gijsdevries/esmog_snuffelaar/README.md

# esmog_snuffelaar

## Software

## Hardware
### Orders
   - **Order #1** v1.0, 22-6-26, ce8a10
