gijsdevries/esmog_snuffelaar/KiCad/TAPIR E-Smog-Snuffelaar.odt

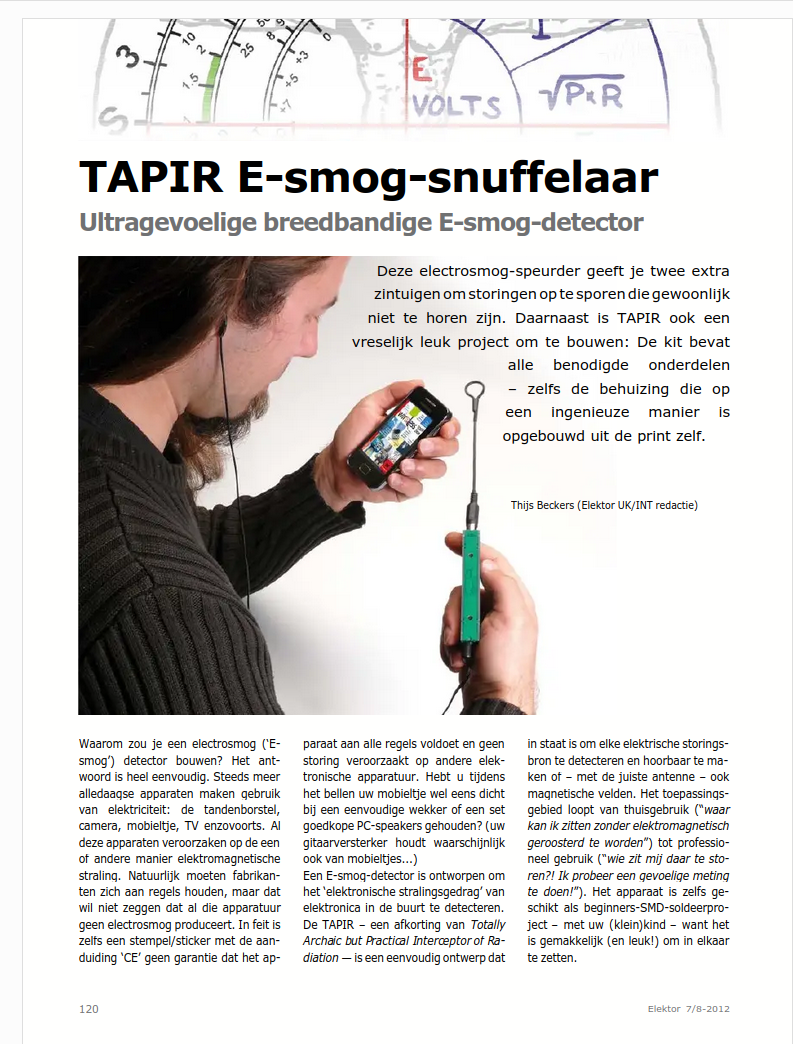
[picture p1: figure]
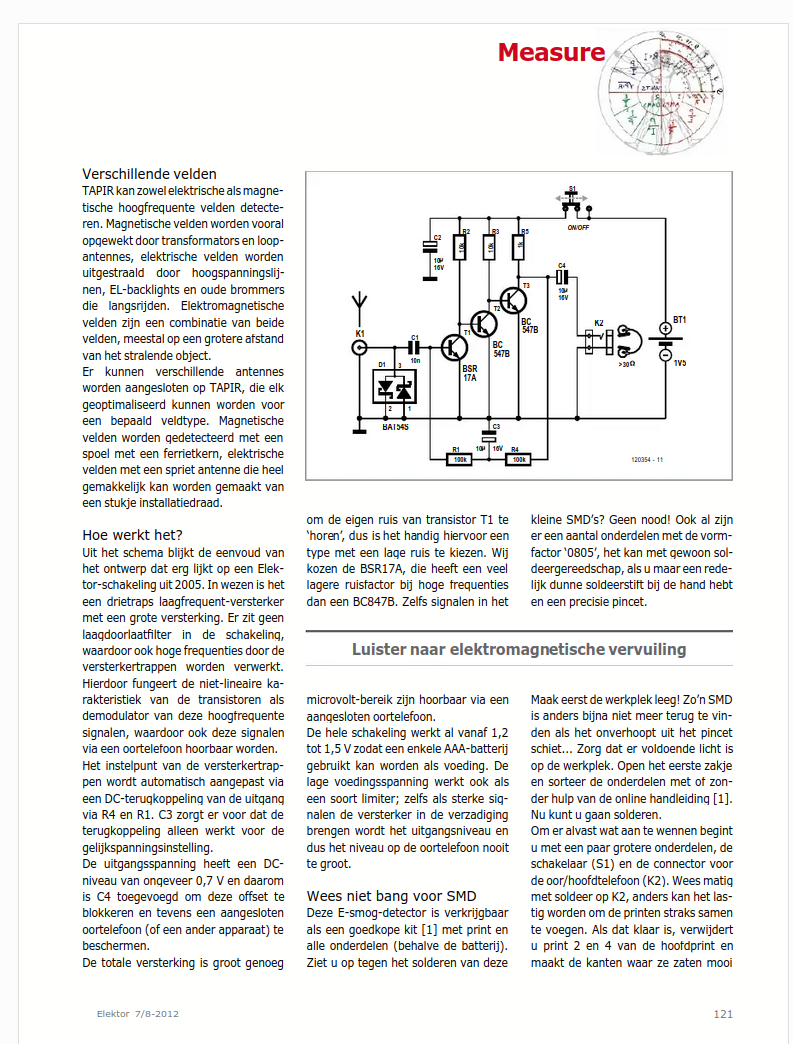
[picture p2: figure]
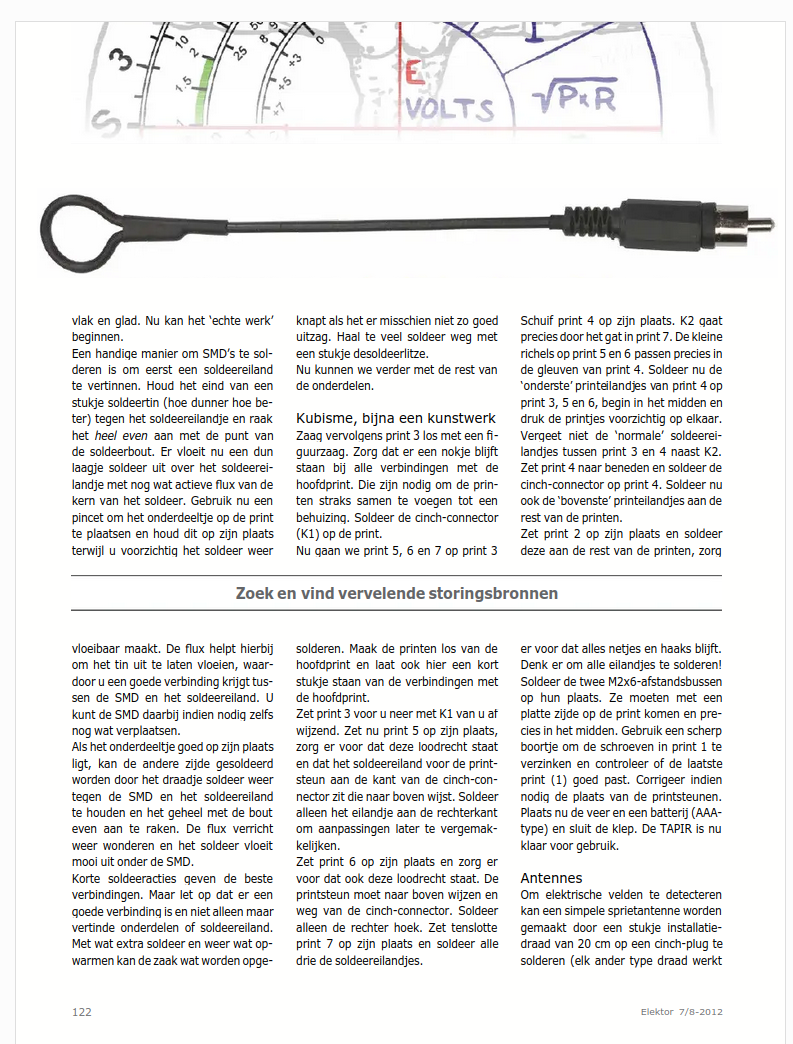
[picture p3: figure]
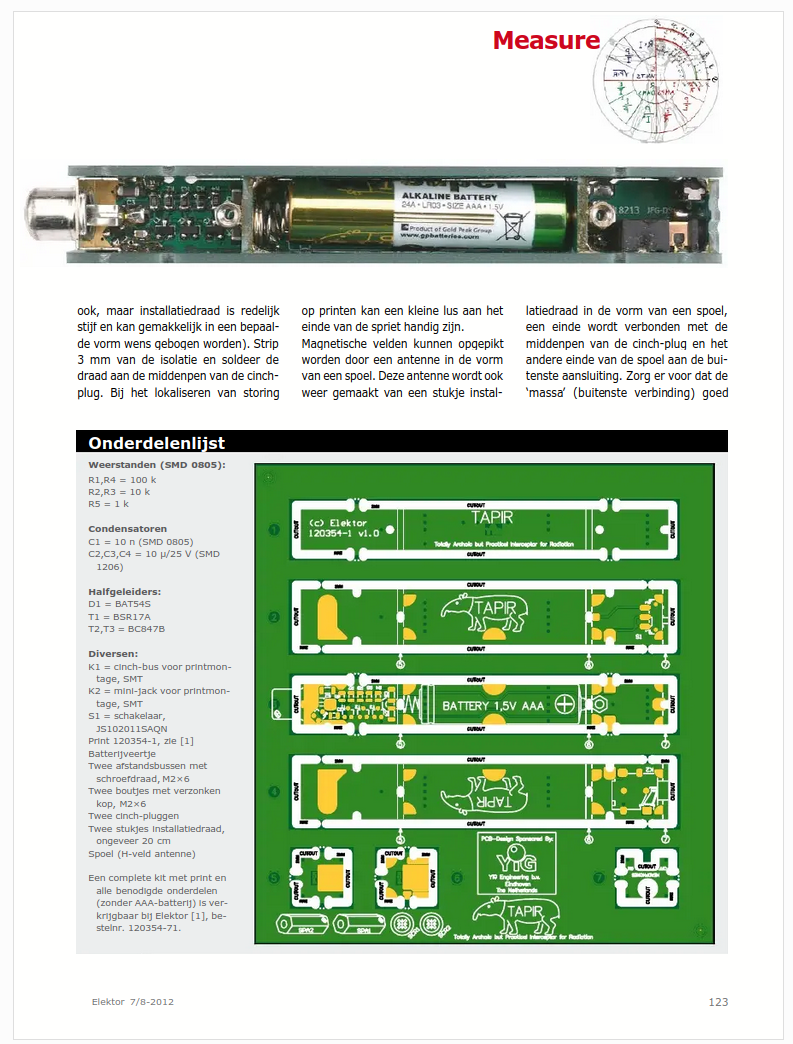
[picture p4: figure]
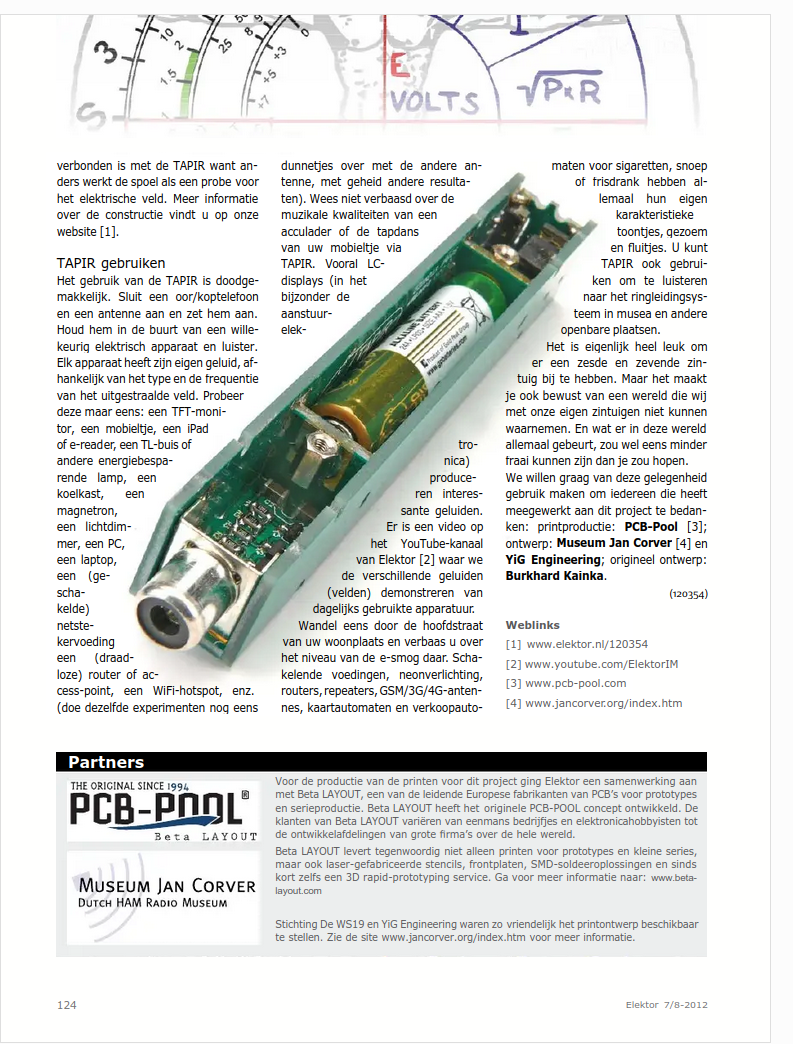
[picture p5: figure]
