gijsdevries/esmog_snuffelaar/KiCad/step/SJ2-35894D-SMT-TR--3DModel-STEP-1.STEP

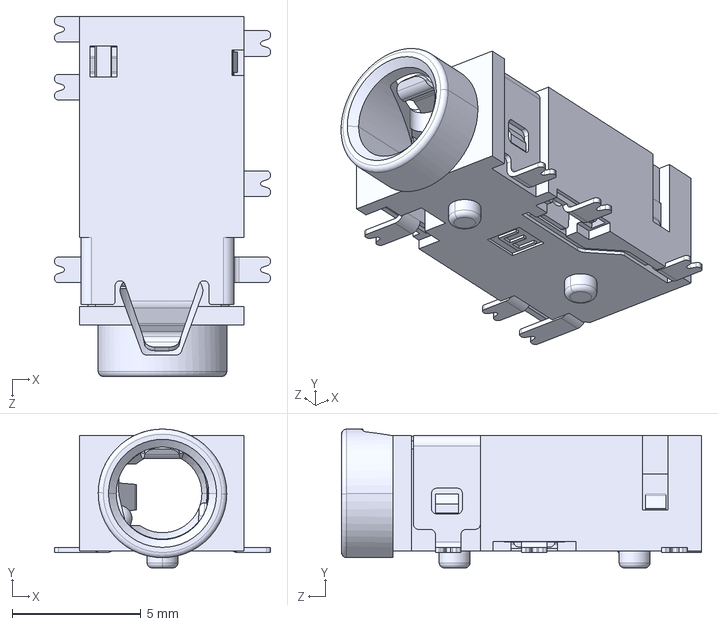
[picture p6: CAD file, 2026-06-19]
KiCad/step/SJ2-35894D-SMT-TR--3DModel-STEP-1.STEP
8.40 x 5.40 x 14.0 mm
