gijsdevries/esmog_snuffelaar/KiCad/step/RCJ-042--3DModel-STEP-1.STEP

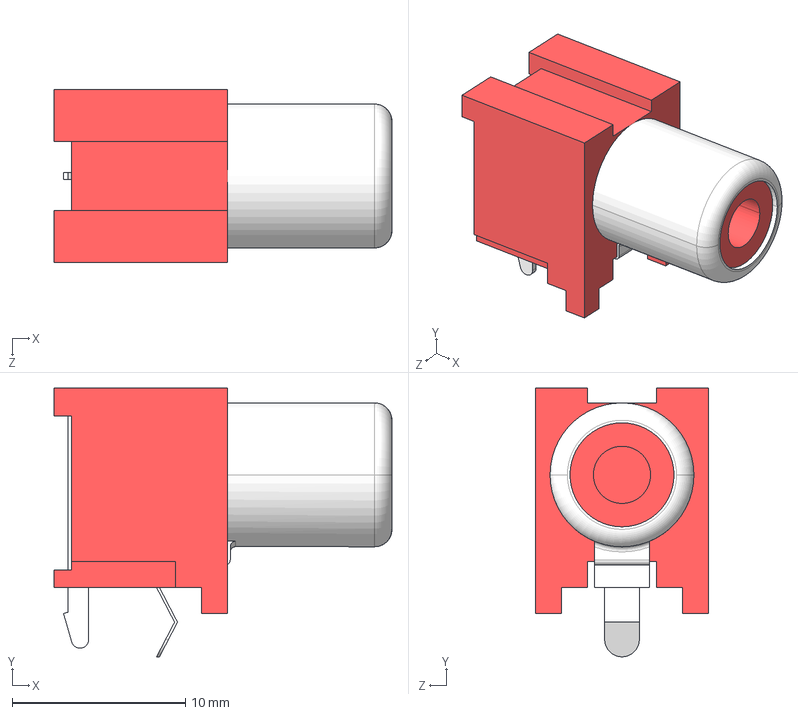
[picture p7: CAD file, 2026-06-19]
KiCad/step/RCJ-042--3DModel-STEP-1.STEP
19.5 x 15.5 x 10.0 mm
