gijsdevries/esmog_snuffelaar/KiCad/Esmog_snuffelaar.kicad_pcb

## KiCad design KiCad/Esmog_snuffelaar.kicad_pcb (2026-06-22)

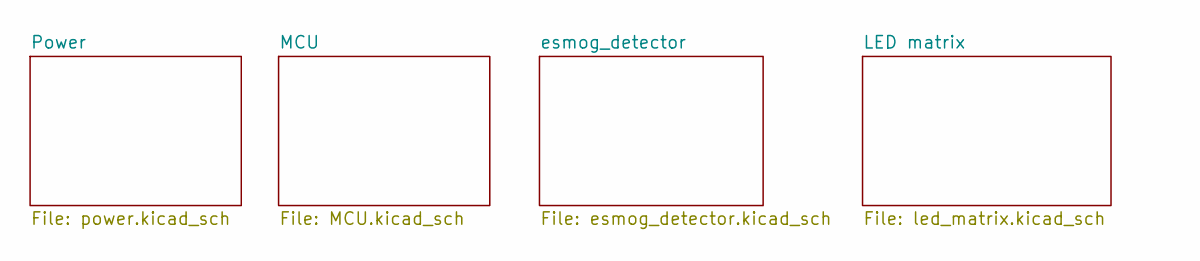
[picture p8: schematic Esmog_snuffelaar.kicad_sch, E smog snuffelaar - Gijs de Vries]

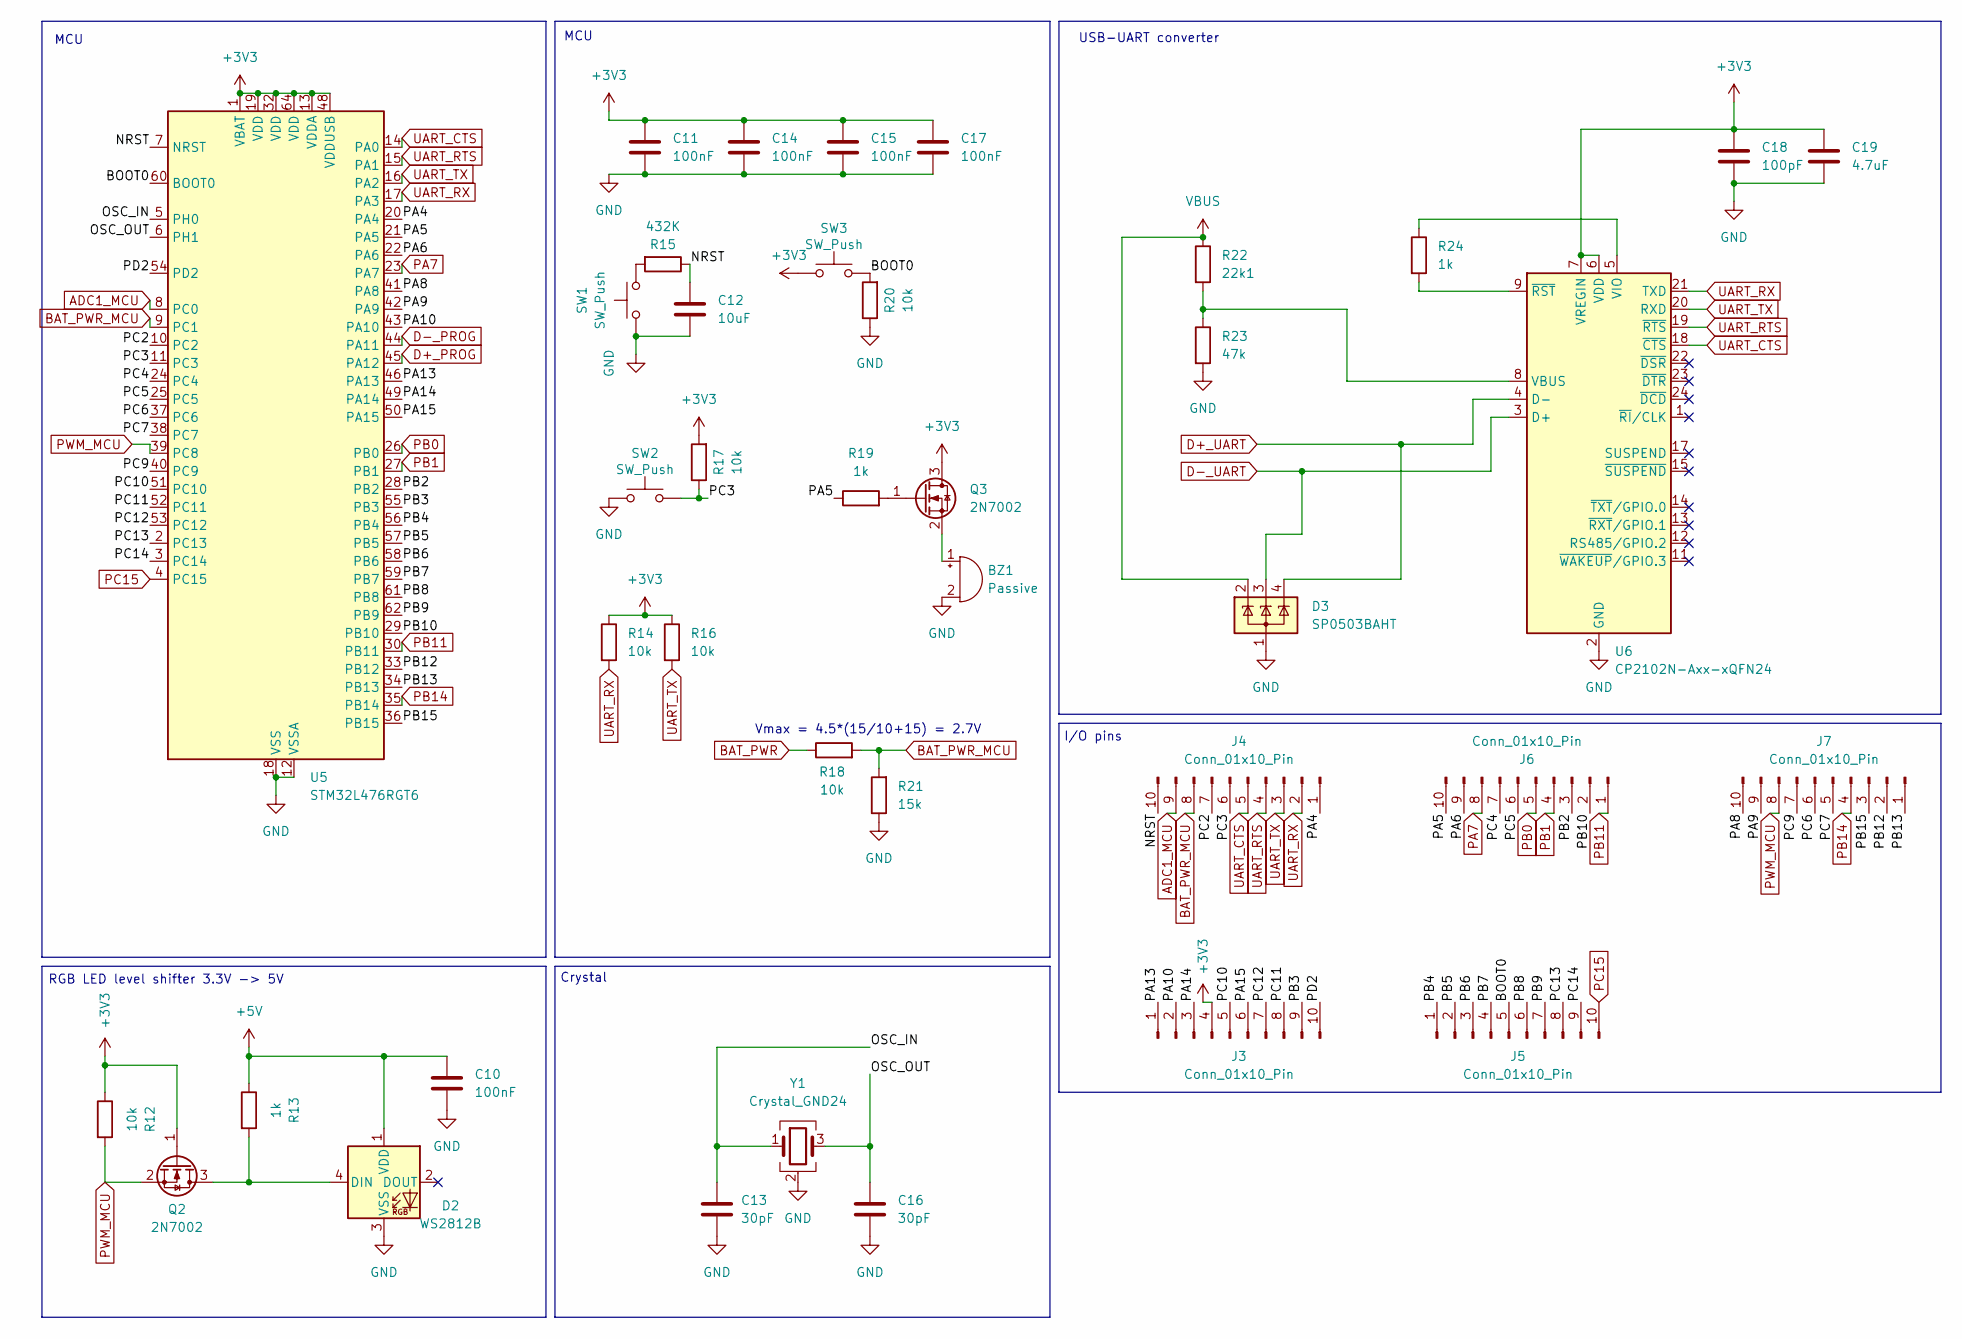
[picture p9: schematic MCU.kicad_sch]

Parts:
BZ1: Passive; Buzzer_TDK_PS1240P02BT_D12.2mm_H6.5mm; JLCPCB Part C76871
C10, C11, C14, C15, C17: 100nF; C_0603_1608Metric_Pad1.08x0.95mm_HandSolder; JLCPCB Part C1591
C12: 10uF; C_0603_1608Metric_Pad1.08x0.95mm_HandSolder; JLCPCB Part C1691
C13, C16: 30pF; C_0603_1608Metric_Pad1.08x0.95mm_HandSolder; JLCPCB Part C1658
C18: 100pF; C_0603_1608Metric_Pad1.08x0.95mm_HandSolder; JLCPCB Part C14858
C19: 4.7uF; C_0603_1608Metric_Pad1.08x0.95mm_HandSolder; JLCPCB Part C1705
D2: WS2812B; LED_WS2812B_PLCC4_5.0x5.0mm_P3.2mm; JLCPCB Part C527089
D3: SP0503BAHT; SOT-143; JLCPCB Part C7074
J3, J4, J5, J6, J7: Conn_01x10_Pin; PinHeader_2x05_P2.54mm_Vertical; JLCPCB Part C42431818
Q2, Q3: 2N7002; SOT-23; JLCPCB Part C916396
R12, R14, R16, R17, R18, R20: 10k; R_0603_1608Metric_Pad0.98x0.95mm_HandSolder; JLCPCB Part C2930027
R13, R19, R24: 1k; R_0603_1608Metric_Pad0.98x0.95mm_HandSolder; JLCPCB Part C2907002
R15: 432K; R_0603_1608Metric_Pad0.98x0.95mm_HandSolder; JLCPCB Part C234529
R21: 15k; R_0603_1608Metric_Pad0.98x0.95mm_HandSolder; JLCPCB Part C114682
R22: 22k1; R_0603_1608Metric_Pad0.98x0.95mm_HandSolder; JLCPCB Part C25961
R23: 47k; R_0603_1608Metric_Pad0.98x0.95mm_HandSolder; JLCPCB Part C2907042
SW1, SW2, SW3: SW_Push; SW_Push_SPST_NO_Alps_SKRK; JLCPCB Part C115357
U5: STM32L476RGT6; LQFP-64_10x10mm_P0.5mm; JLCPCB Part C74797
U6: CP2102N-Axx-xQFN24; QFN-24-1EP_4x4mm_P0.5mm_EP2.6x2.6mm; JLCPCB Part C964632
Y1: Crystal_GND24; Crystal_SMD_Abracon_ABM8AIG-4Pin_3.2x2.5mm; JLCPCB Part C9002

Connections:
+3V3: C11.2, C14.2, C15.2, C17.2, C18.1, C19.1, J3.4, Q2.1 (G), Q3.3 (D), R12.1, R14.1, R16.1, R17.2, SW3.1, U5.1 (VBAT), U5.13 (VDDA), U5.19 (VDD), U5.32 (VDD), U5.48 (VDDUSB), U5.64 (VDD), U6.6 (VDD), U6.7 (VREGIN); also elsewhere on the board
+5V: C10.2, D2.1 (VDD), R13.1; also elsewhere on the board
/MCU/BOOT0: J5.5, R20.2, SW3.2, U5.60 (BOOT0)
/MCU/NRST: C12.2, J4.10, R15.1, U5.7 (NRST)
/MCU/OSC_IN: C13.2, U5.5 (PH0), Y1.1
/MCU/OSC_OUT: C16.2, U5.6 (PH1), Y1.3
/MCU/PA4: J4.1, U5.20 (PA4)
/MCU/PA5: J6.10, R19.1, U5.21 (PA5)
/MCU/PA6: J6.9, U5.22 (PA6)
/MCU/PA8: J7.10, U5.41 (PA8)
/MCU/PA9: J7.9, U5.42 (PA9)
/MCU/PA10: J3.2, U5.43 (PA10)
/MCU/PA13: J3.1, U5.46 (PA13)
/MCU/PA14: J3.3, U5.49 (PA14)
/MCU/PA15: J3.6, U5.50 (PA15)
/MCU/PB2: J6.3, U5.28 (PB2)
/MCU/PB3: J3.9, U5.55 (PB3)
/MCU/PB4: J5.1, U5.56 (PB4)
/MCU/PB5: J5.2, U5.57 (PB5)
/MCU/PB6: J5.3, U5.58 (PB6)
/MCU/PB7: J5.4, U5.59 (PB7)
/MCU/PB8: J5.6, U5.61 (PB8)
/MCU/PB9: J5.7, U5.62 (PB9)
/MCU/PB10: J6.2, U5.29 (PB10)
/MCU/PB12: J7.2, U5.33 (PB12)
/MCU/PB13: J7.1, U5.34 (PB13)
/MCU/PB15: J7.3, U5.36 (PB15)
/MCU/PC2: J4.7, U5.10 (PC2)
/MCU/PC3: J4.6, R17.1, SW2.2, U5.11 (PC3)
/MCU/PC4: J6.7, U5.24 (PC4)
/MCU/PC5: J6.6, U5.25 (PC5)
/MCU/PC6: J7.6, U5.37 (PC6)
/MCU/PC7: J7.5, U5.38 (PC7)
/MCU/PC9: J7.7, U5.40 (PC9)
/MCU/PC10: J3.5, U5.51 (PC10)
/MCU/PC11: J3.8, U5.52 (PC11)
/MCU/PC12: J3.7, U5.53 (PC12)
/MCU/PC13: J5.8, U5.2 (PC13)
/MCU/PC14: J5.9, U5.3 (PC14)
/MCU/PD2: J3.10, U5.54 (PD2)
ADC1_MCU: J4.9, U5.8 (PC0); also elsewhere on the board
BAT_PWR: R18.1; also elsewhere on the board
BAT_PWR_MCU: J4.8, R18.2, R21.2, U5.9 (PC1)
D+_PROG: U5.45 (PA12); also elsewhere on the board
D+_UART: D3.4 (K), U6.4 (D-); also elsewhere on the board
D-_PROG: U5.44 (PA11); also elsewhere on the board
D-_UART: D3.3 (K), U6.3 (D+); also elsewhere on the board
GND: BZ1.2 (-), C10.1, C11.1, C12.1, C13.1, C14.1, C15.1, C16.1, C17.1, C18.2, C19.2, D2.3 (VSS), D3.1 (A), R20.1, R21.1, R23.2, SW1.1, SW2.1, U5.12 (VSSA), U5.18 (VSS), U5.31 (VSS), U5.47 (VSS), U5.63 (VSS), U6.2 (GND), U6.25 (GND), Y1.2 (G), Y1.4 (G); also elsewhere on the board
unnamed: BZ1.1 (+), Q3.2 (S)
unnamed: D2.4 (DIN), Q2.3 (D), R13.2
unnamed: Q3.1 (G), R19.2
unnamed: R15.2, SW1.2
unnamed: R22.2, R23.1, U6.8 (VBUS)
unnamed: R24.1, U6.5 (VIO)
unnamed: R24.2, U6.9 (~RST)
PA7: J6.8, U5.23 (PA7); also elsewhere on the board
PB0: J6.5, U5.26 (PB0); also elsewhere on the board
PB1: J6.4, U5.27 (PB1); also elsewhere on the board
PB11: J6.1, U5.30 (PB11); also elsewhere on the board
PB14: J7.4, U5.35 (PB14); also elsewhere on the board
PC15: J5.10, U5.4 (PC15)
PWM_MCU: J7.8, Q2.2 (S), R12.2, U5.39 (PC8)
UART_CTS: J4.5, U5.14 (PA0), U6.18 (~CTS)
UART_RTS: J4.4, U5.15 (PA1), U6.19 (~RTS)
UART_RX: J4.2, R14.2, U5.17 (PA3), U6.21 (TXD)
UART_TX: J4.3, R16.2, U5.16 (PA2), U6.20 (RXD)
VBUS: D3.2 (K), R22.1; also elsewhere on the board

Notes on the sheet:
MCU
I/O pins
Crystal
Vmax = 4.5*(15/10+15) = 2.7V
RGB LED level shifter 3.3V -> 5V
USB-UART converter

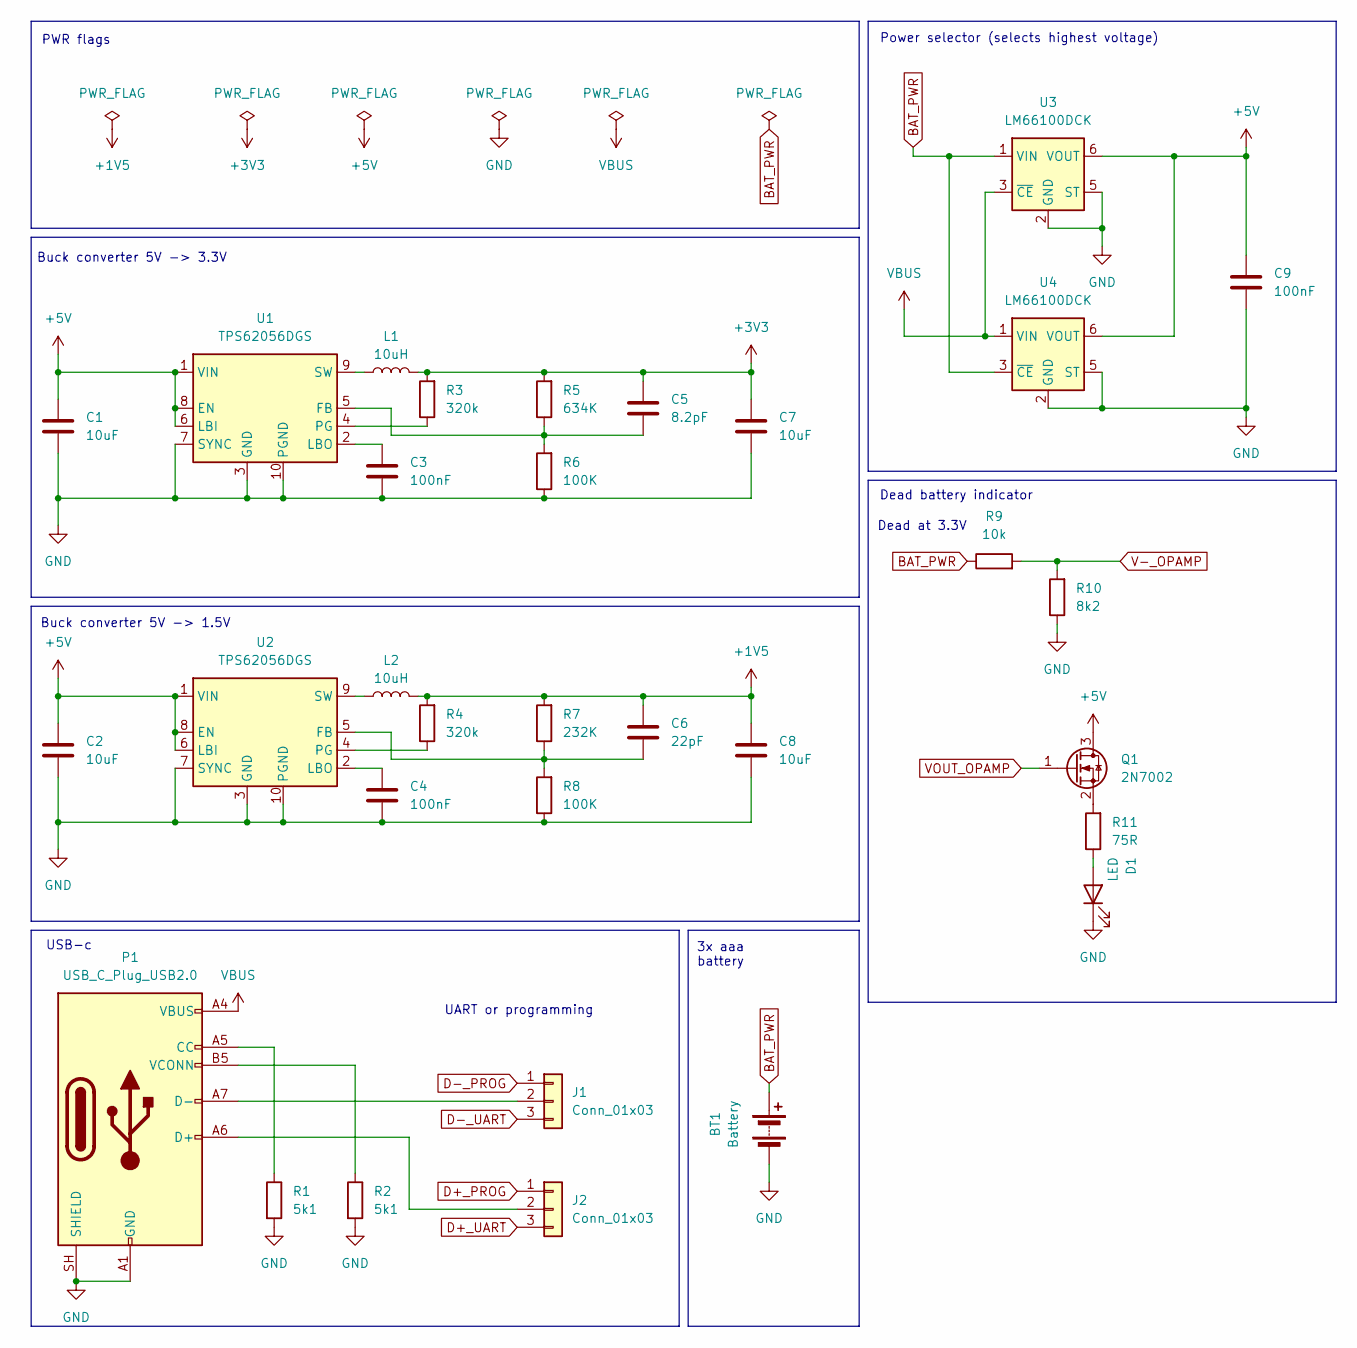
[picture p10: schematic power.kicad_sch]

Parts:
BT1: Battery; BatteryHolder_Keystone_2479_3xAAA; JLCPCB Part C5290193
C1, C2, C7, C8: 10uF; C_0603_1608Metric_Pad1.08x0.95mm_HandSolder; JLCPCB Part C1691
C3, C4, C9: 100nF; C_0603_1608Metric_Pad1.08x0.95mm_HandSolder; JLCPCB Part C1591
C5: 8.2pF; C_0603_1608Metric_Pad1.08x0.95mm_HandSolder; JLCPCB Part C1685
C6: 22pF; C_0603_1608Metric_Pad1.08x0.95mm_HandSolder; JLCPCB Part C1653
D1: LED; LED_0603_1608Metric; JLCPCB Part C2286
J1, J2: Conn_01x03; PinHeader_1x03_P2.54mm_Vertical
L1, L2: 10uH; L_APV_APH0420; JLCPCB Part C181721
P1: USB_C_Plug_USB2.0; USB_C_Receptacle_XKB_U262-16XN-4BVC11; JLCPCB Part C3025063
Q1: 2N7002; SOT-23; JLCPCB Part C916396
R1, R2: 5k1; R_0603_1608Metric_Pad0.98x0.95mm_HandSolder; JLCPCB Part C2907044
R3, R4: 320k; R_0603_1608Metric_Pad0.98x0.95mm_HandSolder; JLCPCB Part C862677
R5: 634K; R_0603_1608Metric_Pad0.98x0.95mm_HandSolder; JLCPCB Part C65831
R6, R8: 100K; R_0603_1608Metric_Pad0.98x0.95mm_HandSolder; JLCPCB Part C2906980
R7: 232K; R_0603_1608Metric_Pad0.98x0.95mm_HandSolder; JLCPCB Part C22913
R9: 10k; R_0603_1608Metric_Pad0.98x0.95mm_HandSolder; JLCPCB Part C2930027
R10: 8k2; R_0603_1608Metric_Pad0.98x0.95mm_HandSolder; JLCPCB Part C114637
R11: 75R; R_0603_1608Metric_Pad0.98x0.95mm_HandSolder; JLCPCB Part C112309
U1, U2: TPS62056DGS; TSSOP-10_3x3mm_P0.5mm; JLCPCB Part C7097
U3, U4: LM66100DCK; SOT-363_SC-70-6; JLCPCB Part C2832141

Connections:
+1V5: C6.2, C8.2, L2.2, R4.2, R7.2; also elsewhere on the board
+3V3: C5.2, C7.2, L1.2, R3.2, R5.2; also elsewhere on the board
+5V: C1.2, C2.2, C9.2, Q1.3 (D), U1.1 (VIN), U1.6 (LBI), U1.8 (EN), U2.1 (VIN), U2.6 (LBI), U2.8 (EN), U3.6 (VOUT), U4.6 (VOUT); also elsewhere on the board
BAT_PWR: BT1.1 (+), R9.1, U3.1 (VIN), U4.3 (~CE); also elsewhere on the board
D+_PROG: J2.1; also elsewhere on the board
D+_UART: J2.3; also elsewhere on the board
D-_PROG: J1.1; also elsewhere on the board
D-_UART: J1.3; also elsewhere on the board
GND: BT1.2 (-), C1.1, C2.1, C3.1, C4.1, C7.1, C8.1, C9.1, D1.1 (K), P1.A1 (GND), P1.A12 (GND), P1.B1 (GND), P1.B12 (GND), P1.SH (SHIELD), R1.2, R2.2, R6.1, R8.1, R10.1, U1.3 (GND), U1.7 (SYNC), U1.10 (PGND), U2.3 (GND), U2.7 (SYNC), U2.10 (PGND), U3.2 (GND), U3.5 (ST), U4.2 (GND), U4.5 (ST); also elsewhere on the board
unnamed: D1.2 (A), R11.1
unnamed: J1.2, P1.A7 (D-)
unnamed: J2.2, P1.A6 (D+)
unnamed: P1.A5 (CC), R1.1
unnamed: P1.B5 (VCONN), R2.1
unnamed: Q1.2 (S), R11.2
unnamed: C5.1, R5.1, R6.2, U1.5 (FB)
unnamed: C3.2, U1.2 (LBO)
unnamed: R3.1, U1.4 (PG)
unnamed: L1.1, U1.9 (SW)
unnamed: C6.1, R7.1, R8.2, U2.5 (FB)
unnamed: C4.2, U2.2 (LBO)
unnamed: R4.1, U2.4 (PG)
unnamed: L2.1, U2.9 (SW)
V-_OPAMP: R9.2, R10.2; also elsewhere on the board
VBUS: P1.A4 (VBUS), P1.A9 (VBUS), P1.B4 (VBUS), P1.B9 (VBUS), U3.3 (~CE), U4.1 (VIN); also elsewhere on the board
VOUT_OPAMP: Q1.1 (G); also elsewhere on the board

Notes on the sheet:
3x aaa battery
Buck converter 5V -> 3.3V
Dead at 3.3V
Power selector (selects highest voltage)
Buck converter 5V -> 1.5V
UART or programming
Dead battery indicator
PWR flags
USB-c

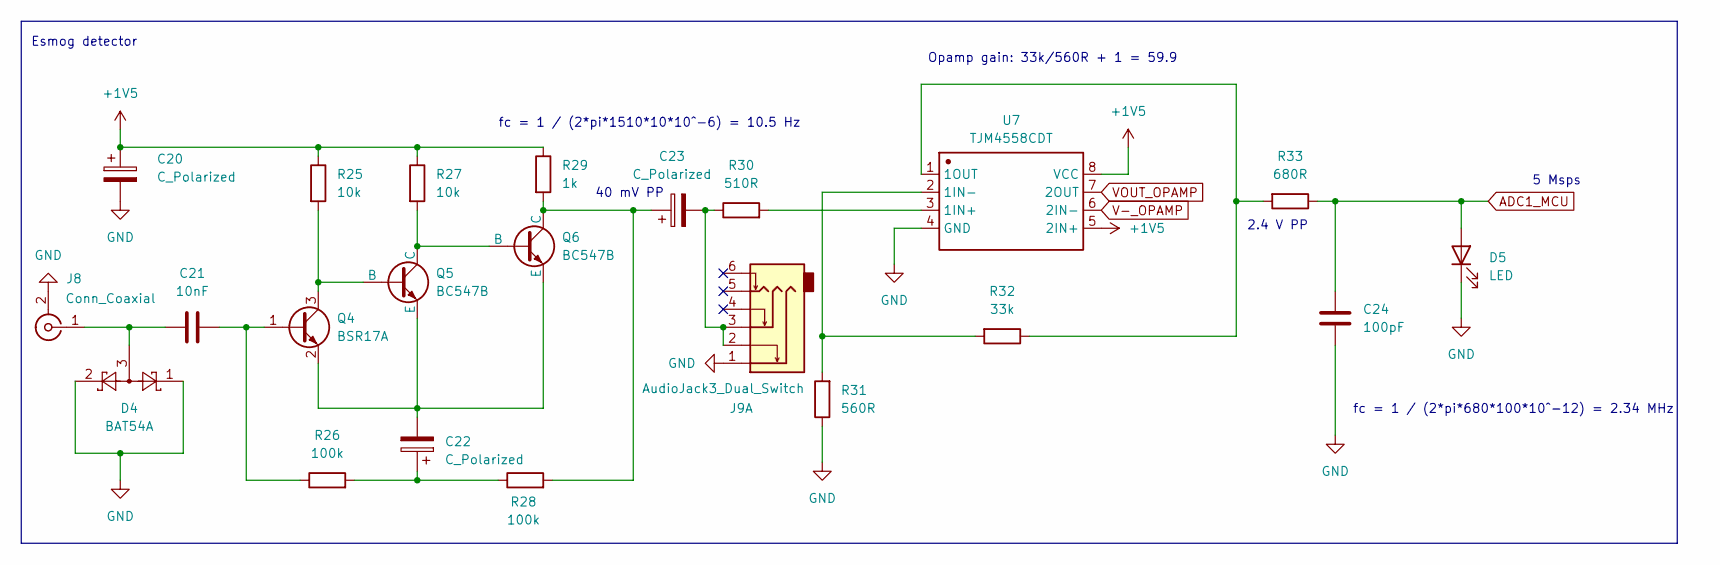
[picture p11: schematic esmog_detector.kicad_sch, esmog detector]

Parts:
C20, C22, C23: C_Polarized; CP_Elec_4x5.4; JLCPCB Part C213487
C21: 10nF; C_0603_1608Metric_Pad1.08x0.95mm_HandSolder; JLCPCB Part C1589
C24: 100pF; C_0603_1608Metric_Pad1.08x0.95mm_HandSolder; JLCPCB Part C14858
D4: BAT54A; SOT-23; JLCPCB Part C12743
D5: LED; LED_0603_1608Metric; JLCPCB Part C2286
J8: Conn_Coaxial; CONN-TH_AV-5; JLCPCB Part C18080
J9: AudioJack3_Dual_Switch; Audio_jack; JLCPCB Part C128987
Q4: BSR17A; SOT-23; JLCPCB Part C46682449
Q5, Q6: BC547B; TO-92; JLCPCB Part C713613
R25, R27: 10k; R_0603_1608Metric_Pad0.98x0.95mm_HandSolder; JLCPCB Part C2930027
R26, R28: 100k; R_0603_1608Metric_Pad0.98x0.95mm_HandSolder; JLCPCB Part C2906980
R29: 1k; R_0603_1608Metric_Pad0.98x0.95mm_HandSolder; JLCPCB Part C2907002
R30: 510R; R_0603_1608Metric_Pad0.98x0.95mm_HandSolder; JLCPCB Part C113299
R31: 560R; R_0603_1608Metric_Pad0.98x0.95mm_HandSolder; JLCPCB Part C23204
R32: 33k; R_0603_1608Metric_Pad0.98x0.95mm_HandSolder; JLCPCB Part C844778
R33: 680R; R_0603_1608Metric_Pad0.98x0.95mm_HandSolder; JLCPCB Part C23228
U7: TJM4558CDT; SOIC-8_5.3x5.3mm_P1.27mm; Manufacturer Part TJM4558CDT; JLCPCB Part C6955

Connections:
+1V5: C20.1, R25.1, R27.1, R29.1, U7.5 (2IN+), U7.8 (VCC); also elsewhere on the board
ADC1_MCU: C24.2, D5.2 (A), R33.1; also elsewhere on the board
GND: C20.2, C24.1, D4.1, D4.2, D5.1 (K), J8.2 (Ext), J9.1, R31.1, U7.4 (GND); also elsewhere on the board
unnamed: C22.1, R26.2, R28.1
unnamed: C23.2, J9.2, J9.3, R30.1
unnamed: C21.1, D4.3, J8.1 (In)
unnamed: C21.2, Q4.1 (B), R26.1
unnamed: Q4.3 (C), Q5.2 (B), R25.2
unnamed: C22.2, Q4.2 (E), Q5.3 (E), Q6.3 (E)
unnamed: Q5.1 (C), Q6.2 (B), R27.2
unnamed: C23.1, Q6.1 (C), R28.2, R29.2
unnamed: R30.2, U7.3 (1IN+)
unnamed: R31.2, R32.2, U7.2 (1IN-)
unnamed: R32.1, R33.2, U7.1 (1OUT)
V-_OPAMP: U7.6 (2IN-); also elsewhere on the board
VOUT_OPAMP: U7.7 (2OUT); also elsewhere on the board

Notes on the sheet:
5 Msps
fc = 1 / (2*pi*680*100*10^-12) = 2.34 MHz
40 mV PP
Esmog detector
fc = 1 / (2*pi*1510*10*10^-6) = 10.5 Hz
Opamp gain: 33k/560R + 1 = 59.9
2.4 V PP

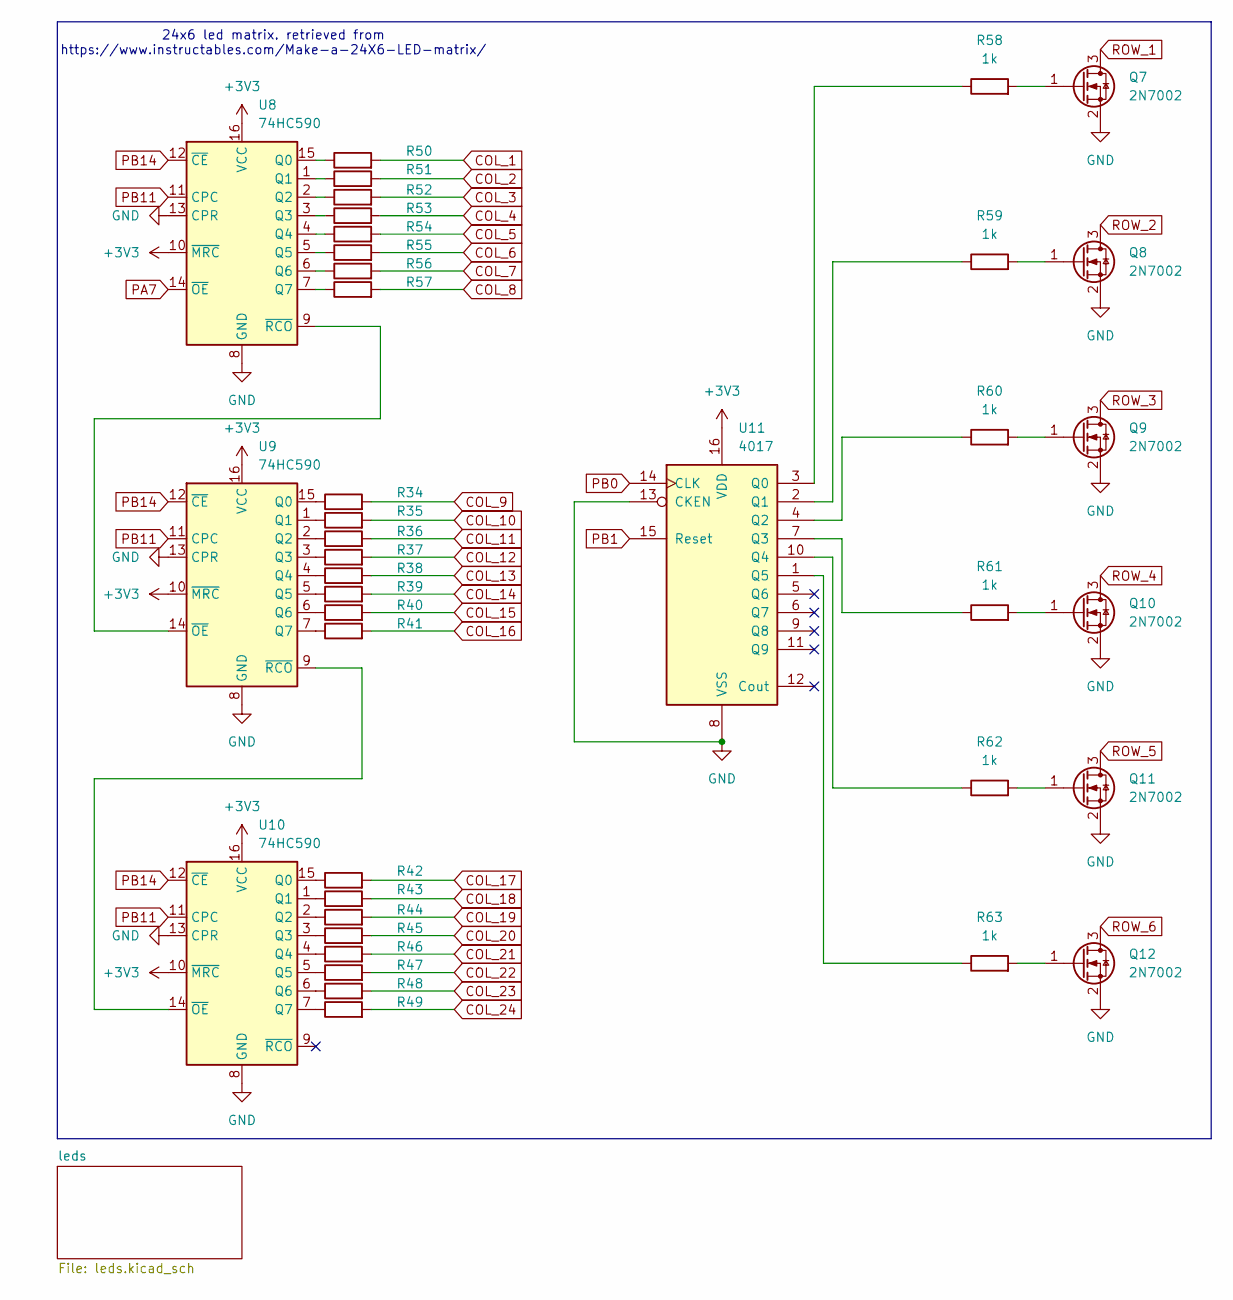
[picture p12: schematic led_matrix.kicad_sch]

Parts:
Q7, Q8, Q9, Q10, Q11, Q12: 2N7002; SOT-23; JLCPCB Part C916396
R34, R35, R36, R37, R38, R39, R40, R41, R42, R43, R44, R45, R46, R47, R48, R49, R50, R51, R52, R53, R54, R55, R56, R57: 75R; R_0603_1608Metric_Pad0.98x0.95mm_HandSolder; JLCPCB Part C112309
R58, R59, R60, R61, R62, R63: 1k; R_0603_1608Metric_Pad0.98x0.95mm_HandSolder; JLCPCB Part C2907002
U8, U9, U10: 74HC590; SOIC-16_3.9x9.9mm_P1.27mm; JLCPCB Part C5947
U11: 4017; SO-16_3.9x9.9mm_P1.27mm; JLCPCB Part C11349

Connections:
+3V3: U8.10 (~MRC), U8.16 (VCC), U9.10 (~MRC), U9.16 (VCC), U10.10 (~MRC), U10.16 (VCC), U11.16 (VDD); also elsewhere on the board
COL_1: R50.2; also elsewhere on the board
COL_2: R51.2; also elsewhere on the board
COL_3: R52.2; also elsewhere on the board
COL_4: R53.2; also elsewhere on the board
COL_5: R54.2; also elsewhere on the board
COL_6: R55.2; also elsewhere on the board
COL_7: R56.2; also elsewhere on the board
COL_8: R57.2; also elsewhere on the board
COL_9: R34.2; also elsewhere on the board
COL_10: R35.2; also elsewhere on the board
COL_11: R36.2; also elsewhere on the board
COL_12: R37.2; also elsewhere on the board
COL_13: R38.2; also elsewhere on the board
COL_14: R39.2; also elsewhere on the board
COL_15: R40.2; also elsewhere on the board
COL_16: R41.2; also elsewhere on the board
COL_17: R42.2; also elsewhere on the board
COL_18: R43.2; also elsewhere on the board
COL_19: R44.2; also elsewhere on the board
COL_20: R45.2; also elsewhere on the board
COL_21: R46.2; also elsewhere on the board
COL_22: R47.2; also elsewhere on the board
COL_23: R48.2; also elsewhere on the board
COL_24: R49.2; also elsewhere on the board
GND: Q7.2 (S), Q8.2 (S), Q9.2 (S), Q10.2 (S), Q11.2 (S), Q12.2 (S), U8.8 (GND), U8.13 (CPR), U9.8 (GND), U9.13 (CPR), U10.8 (GND), U10.13 (CPR), U11.8 (VSS), U11.13 (CKEN); also elsewhere on the board
unnamed: Q7.1 (G), R58.2
unnamed: Q8.1 (G), R59.2
unnamed: Q9.1 (G), R60.2
unnamed: Q10.1 (G), R61.2
unnamed: Q11.1 (G), R62.2
unnamed: Q12.1 (G), R63.2
unnamed: R50.1, U8.15 (Q0)
unnamed: R51.1, U8.1 (Q1)
unnamed: R52.1, U8.2 (Q2)
unnamed: R53.1, U8.3 (Q3)
unnamed: R54.1, U8.4 (Q4)
unnamed: R55.1, U8.5 (Q5)
unnamed: R56.1, U8.6 (Q6)
unnamed: R57.1, U8.7 (Q7)
unnamed: U8.9 (~RCO), U9.14 (~OE)
unnamed: R34.1, U9.15 (Q0)
unnamed: R35.1, U9.1 (Q1)
unnamed: R36.1, U9.2 (Q2)
unnamed: R37.1, U9.3 (Q3)
unnamed: R38.1, U9.4 (Q4)
unnamed: R39.1, U9.5 (Q5)
unnamed: R40.1, U9.6 (Q6)
unnamed: R41.1, U9.7 (Q7)
unnamed: R42.1, U10.15 (Q0)
unnamed: R43.1, U10.1 (Q1)
unnamed: R44.1, U10.2 (Q2)
unnamed: R45.1, U10.3 (Q3)
unnamed: R46.1, U10.4 (Q4)
unnamed: R47.1, U10.5 (Q5)
unnamed: R48.1, U10.6 (Q6)
unnamed: R49.1, U10.7 (Q7)
unnamed: U9.9 (~RCO), U10.14 (~OE)
unnamed: R58.1, U11.3 (Q0)
unnamed: R59.1, U11.2 (Q1)
unnamed: R60.1, U11.4 (Q2)
unnamed: R61.1, U11.7 (Q3)
unnamed: R62.1, U11.10 (Q4)
unnamed: R63.1, U11.1 (Q5)
PA7: U8.14 (~OE); also elsewhere on the board
PB0: U11.14 (CLK); also elsewhere on the board
PB1: U11.15 (Reset); also elsewhere on the board
PB11: U8.11 (CPC), U9.11 (CPC), U10.11 (CPC); also elsewhere on the board
PB14: U8.12 (~CE), U9.12 (~CE), U10.12 (~CE); also elsewhere on the board
ROW_1: Q7.3 (D); also elsewhere on the board
ROW_2: Q8.3 (D); also elsewhere on the board
ROW_3: Q9.3 (D); also elsewhere on the board
ROW_4: Q10.3 (D); also elsewhere on the board
ROW_5: Q11.3 (D); also elsewhere on the board
ROW_6: Q12.3 (D); also elsewhere on the board

Notes on the sheet:
24x6 led matrix. retrieved from https://www.instructables.com/Make-a-24X6-LED-matrix/

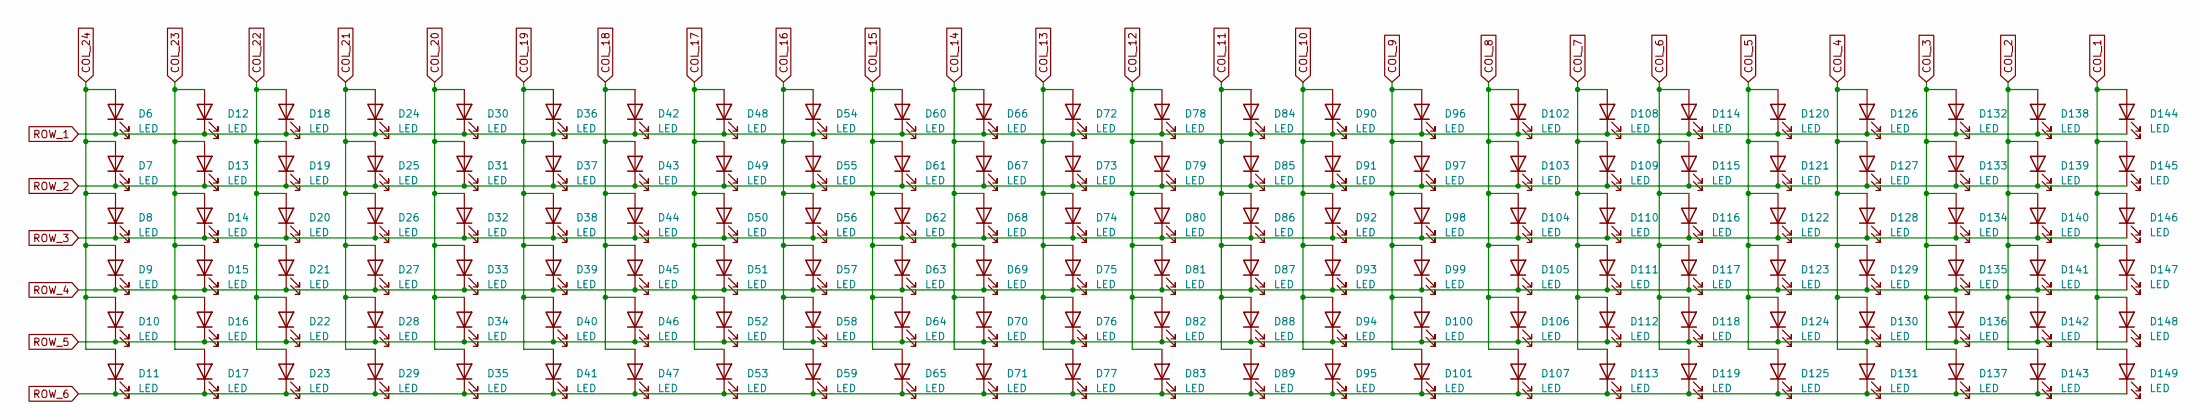
[picture p13: schematic leds.kicad_sch]

Parts:
D6, D7, D8, D9, D10, D11, D12, D13, D14, D15, D16, D17, D18, D19, D20, D21, D22, D23, D24, D25, D26, D27, D28, D29, D30, D31, D32, D33, D34, D35, D36, D37, D38, D39, D40, D41, D42, D43, D44, D45, D46, D47, D48, D49, D50, D51, D52, D53, D54, D55, D56, D57, D58, D59, D60, D61, D62, D63, D64, D65, D66, D67, D68, D69, D70, D71, D72, D73, D74, D75, D76, D77, D78, D79, D80, D81, D82, D83, D84, D85, D86, D87, D88, D89, D90, D91, D92, D93, D94, D95, D96, D97, D98, D99, D100, D101, D102, D103, D104, D105, D106, D107, D108, D109, D110, D111, D112, D113, D114, D115, D116, D117, D118, D119, D120, D121, D122, D123, D124, D125, D126, D127, D128, D129, D130, D131, D132, D133, D134, D135, D136, D137, D138, D139, D140, D141, D142, D143, D144, D145, D146, D147, D148, D149: LED; LED_0603_1608Metric; JLCPCB Part C2286

Connections:
COL_1: D144.2 (A), D145.2 (A), D146.2 (A), D147.2 (A), D148.2 (A), D149.2 (A); also elsewhere on the board
COL_2: D138.2 (A), D139.2 (A), D140.2 (A), D141.2 (A), D142.2 (A), D143.2 (A); also elsewhere on the board
COL_3: D132.2 (A), D133.2 (A), D134.2 (A), D135.2 (A), D136.2 (A), D137.2 (A); also elsewhere on the board
COL_4: D126.2 (A), D127.2 (A), D128.2 (A), D129.2 (A), D130.2 (A), D131.2 (A); also elsewhere on the board
COL_5: D120.2 (A), D121.2 (A), D122.2 (A), D123.2 (A), D124.2 (A), D125.2 (A); also elsewhere on the board
COL_6: D114.2 (A), D115.2 (A), D116.2 (A), D117.2 (A), D118.2 (A), D119.2 (A); also elsewhere on the board
COL_7: D108.2 (A), D109.2 (A), D110.2 (A), D111.2 (A), D112.2 (A), D113.2 (A); also elsewhere on the board
COL_8: D102.2 (A), D103.2 (A), D104.2 (A), D105.2 (A), D106.2 (A), D107.2 (A); also elsewhere on the board
COL_9: D96.2 (A), D97.2 (A), D98.2 (A), D99.2 (A), D100.2 (A), D101.2 (A); also elsewhere on the board
COL_10: D90.2 (A), D91.2 (A), D92.2 (A), D93.2 (A), D94.2 (A), D95.2 (A); also elsewhere on the board
COL_11: D84.2 (A), D85.2 (A), D86.2 (A), D87.2 (A), D88.2 (A), D89.2 (A); also elsewhere on the board
COL_12: D78.2 (A), D79.2 (A), D80.2 (A), D81.2 (A), D82.2 (A), D83.2 (A); also elsewhere on the board
COL_13: D72.2 (A), D73.2 (A), D74.2 (A), D75.2 (A), D76.2 (A), D77.2 (A); also elsewhere on the board
COL_14: D66.2 (A), D67.2 (A), D68.2 (A), D69.2 (A), D70.2 (A), D71.2 (A); also elsewhere on the board
COL_15: D60.2 (A), D61.2 (A), D62.2 (A), D63.2 (A), D64.2 (A), D65.2 (A); also elsewhere on the board
COL_16: D54.2 (A), D55.2 (A), D56.2 (A), D57.2 (A), D58.2 (A), D59.2 (A); also elsewhere on the board
COL_17: D48.2 (A), D49.2 (A), D50.2 (A), D51.2 (A), D52.2 (A), D53.2 (A); also elsewhere on the board
COL_18: D42.2 (A), D43.2 (A), D44.2 (A), D45.2 (A), D46.2 (A), D47.2 (A); also elsewhere on the board
COL_19: D36.2 (A), D37.2 (A), D38.2 (A), D39.2 (A), D40.2 (A), D41.2 (A); also elsewhere on the board
COL_20: D30.2 (A), D31.2 (A), D32.2 (A), D33.2 (A), D34.2 (A), D35.2 (A); also elsewhere on the board
COL_21: D24.2 (A), D25.2 (A), D26.2 (A), D27.2 (A), D28.2 (A), D29.2 (A); also elsewhere on the board
COL_22: D18.2 (A), D19.2 (A), D20.2 (A), D21.2 (A), D22.2 (A), D23.2 (A); also elsewhere on the board
COL_23: D12.2 (A), D13.2 (A), D14.2 (A), D15.2 (A), D16.2 (A), D17.2 (A); also elsewhere on the board
COL_24: D6.2 (A), D7.2 (A), D8.2 (A), D9.2 (A), D10.2 (A), D11.2 (A); also elsewhere on the board
ROW_1: D6.1 (K), D12.1 (K), D18.1 (K), D24.1 (K), D30.1 (K), D36.1 (K), D42.1 (K), D48.1 (K), D54.1 (K), D60.1 (K), D66.1 (K), D72.1 (K), D78.1 (K), D84.1 (K), D90.1 (K), D96.1 (K), D102.1 (K), D108.1 (K), D114.1 (K), D120.1 (K), D126.1 (K), D132.1 (K), D138.1 (K), D144.1 (K); also elsewhere on the board
ROW_2: D7.1 (K), D13.1 (K), D19.1 (K), D25.1 (K), D31.1 (K), D37.1 (K), D43.1 (K), D49.1 (K), D55.1 (K), D61.1 (K), D67.1 (K), D73.1 (K), D79.1 (K), D85.1 (K), D91.1 (K), D97.1 (K), D103.1 (K), D109.1 (K), D115.1 (K), D121.1 (K), D127.1 (K), D133.1 (K), D139.1 (K), D145.1 (K); also elsewhere on the board
ROW_3: D8.1 (K), D14.1 (K), D20.1 (K), D26.1 (K), D32.1 (K), D38.1 (K), D44.1 (K), D50.1 (K), D56.1 (K), D62.1 (K), D68.1 (K), D74.1 (K), D80.1 (K), D86.1 (K), D92.1 (K), D98.1 (K), D104.1 (K), D110.1 (K), D116.1 (K), D122.1 (K), D128.1 (K), D134.1 (K), D140.1 (K), D146.1 (K); also elsewhere on the board
ROW_4: D9.1 (K), D15.1 (K), D21.1 (K), D27.1 (K), D33.1 (K), D39.1 (K), D45.1 (K), D51.1 (K), D57.1 (K), D63.1 (K), D69.1 (K), D75.1 (K), D81.1 (K), D87.1 (K), D93.1 (K), D99.1 (K), D105.1 (K), D111.1 (K), D117.1 (K), D123.1 (K), D129.1 (K), D135.1 (K), D141.1 (K), D147.1 (K); also elsewhere on the board
ROW_5: D10.1 (K), D16.1 (K), D22.1 (K), D28.1 (K), D34.1 (K), D40.1 (K), D46.1 (K), D52.1 (K), D58.1 (K), D64.1 (K), D70.1 (K), D76.1 (K), D82.1 (K), D88.1 (K), D94.1 (K), D100.1 (K), D106.1 (K), D112.1 (K), D118.1 (K), D124.1 (K), D130.1 (K), D136.1 (K), D142.1 (K), D148.1 (K); also elsewhere on the board
ROW_6: D11.1 (K), D17.1 (K), D23.1 (K), D29.1 (K), D35.1 (K), D41.1 (K), D47.1 (K), D53.1 (K), D59.1 (K), D65.1 (K), D71.1 (K), D77.1 (K), D83.1 (K), D89.1 (K), D95.1 (K), D101.1 (K), D107.1 (K), D113.1 (K), D119.1 (K), D125.1 (K), D131.1 (K), D137.1 (K), D143.1 (K), D149.1 (K); also elsewhere on the board

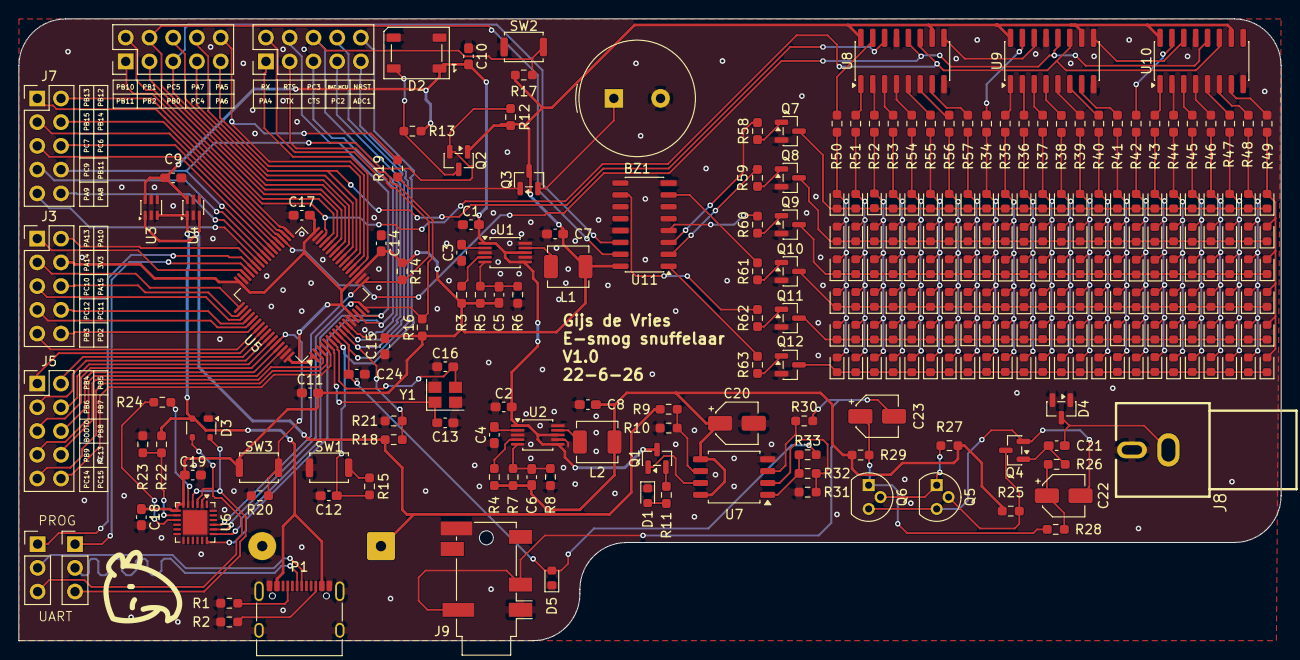
[picture p14: board Esmog_snuffelaar.kicad_pcb from above]

Board: 2 copper layers, 135.0 x 66.5 mm, 277 parts (1 on the bottom side), 163 nets.
