gijsdevries/esmog_snuffelaar/(commit log)

2026-06-19 added kicad project
    [Esmog_snuffelaar.kicad_pcb, Esmog_snuffelaar.kicad_sch, MCU.kicad_sch, RCJ-042--3DModel-STEP-1.STEP, SJ2-35894D-SMT-TR--3DModel-STEP-1.STEP, esmog_detector.kicad_sch, led_matrix.kicad_sch, leds.kicad_sch]
2026-06-20 changed components and excluded from BOM
    [Esmog_snuffelaar.kicad_pcb, MCU.kicad_sch, esmog_detector.kicad_sch, power.kicad_sch]
2026-06-20 changed more part#
    [Esmog_snuffelaar.kicad_pcb, MCU.kicad_sch, esmog_detector.kicad_sch, led_matrix.kicad_sch, power.kicad_sch]
2026-06-21 d+ and d- length matching
    [Esmog_snuffelaar.kicad_pcb]
2026-06-22 changed some out of stock parts
    [Esmog_snuffelaar.kicad_pcb, MCU.kicad_sch, esmog_detector.kicad_sch, led_matrix.kicad_sch, power.kicad_sch]
